bakathefish/LED-PANEL/zine.pdf

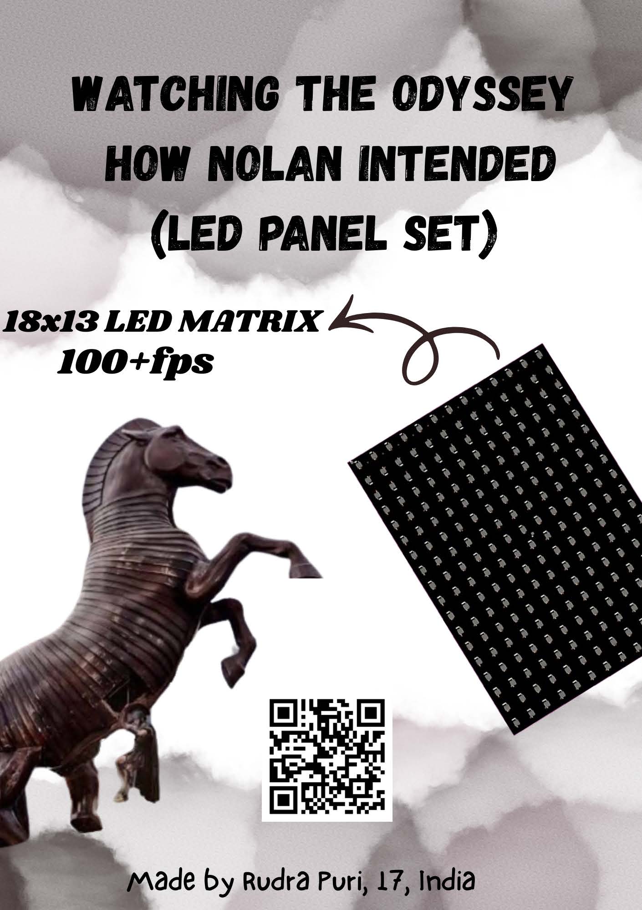
[picture p5: page 1]
