bakathefish/LED-PANEL/(commit log)

2026-08-18 Add README, board images, gerbers folder, and firmware folder
2026-08-18 Correct panel geometry to 13x18, fix board docs, add clean gerber renders
    - grid is 13 columns x 18 rows, not 18x13 (verified against LED
    placement in the fab data: X 10-250mm and Y 10 to -330mm, 20mm pitch)
    - firmware MATRIX_WIDTH/HEIGHT corrected to match, so the serpentine
    XY mapping now lands on the right pixels
    - H2 is a +5V through-hole pad at board centre, not a mounting hole;
    the board has 248 +5V pads and no mounting holes at all
    - note the two sided assembly: LEDs on top, caps and R1 on the bottom
    - replace editor screenshots with full board renders from the gerbers,
    and crop the UI overlay off the schematic export
    - add R1 to the BOM
    [BOM.csv]
2026-08-24 added pcb source
2026-10-14 README: spell the project name LED-PANEL
